aakashvishcoder/risc-v-comp/risc-v comp.kicad_pcb

## KiCad design risc-v comp.kicad_pcb (2026-11-08)

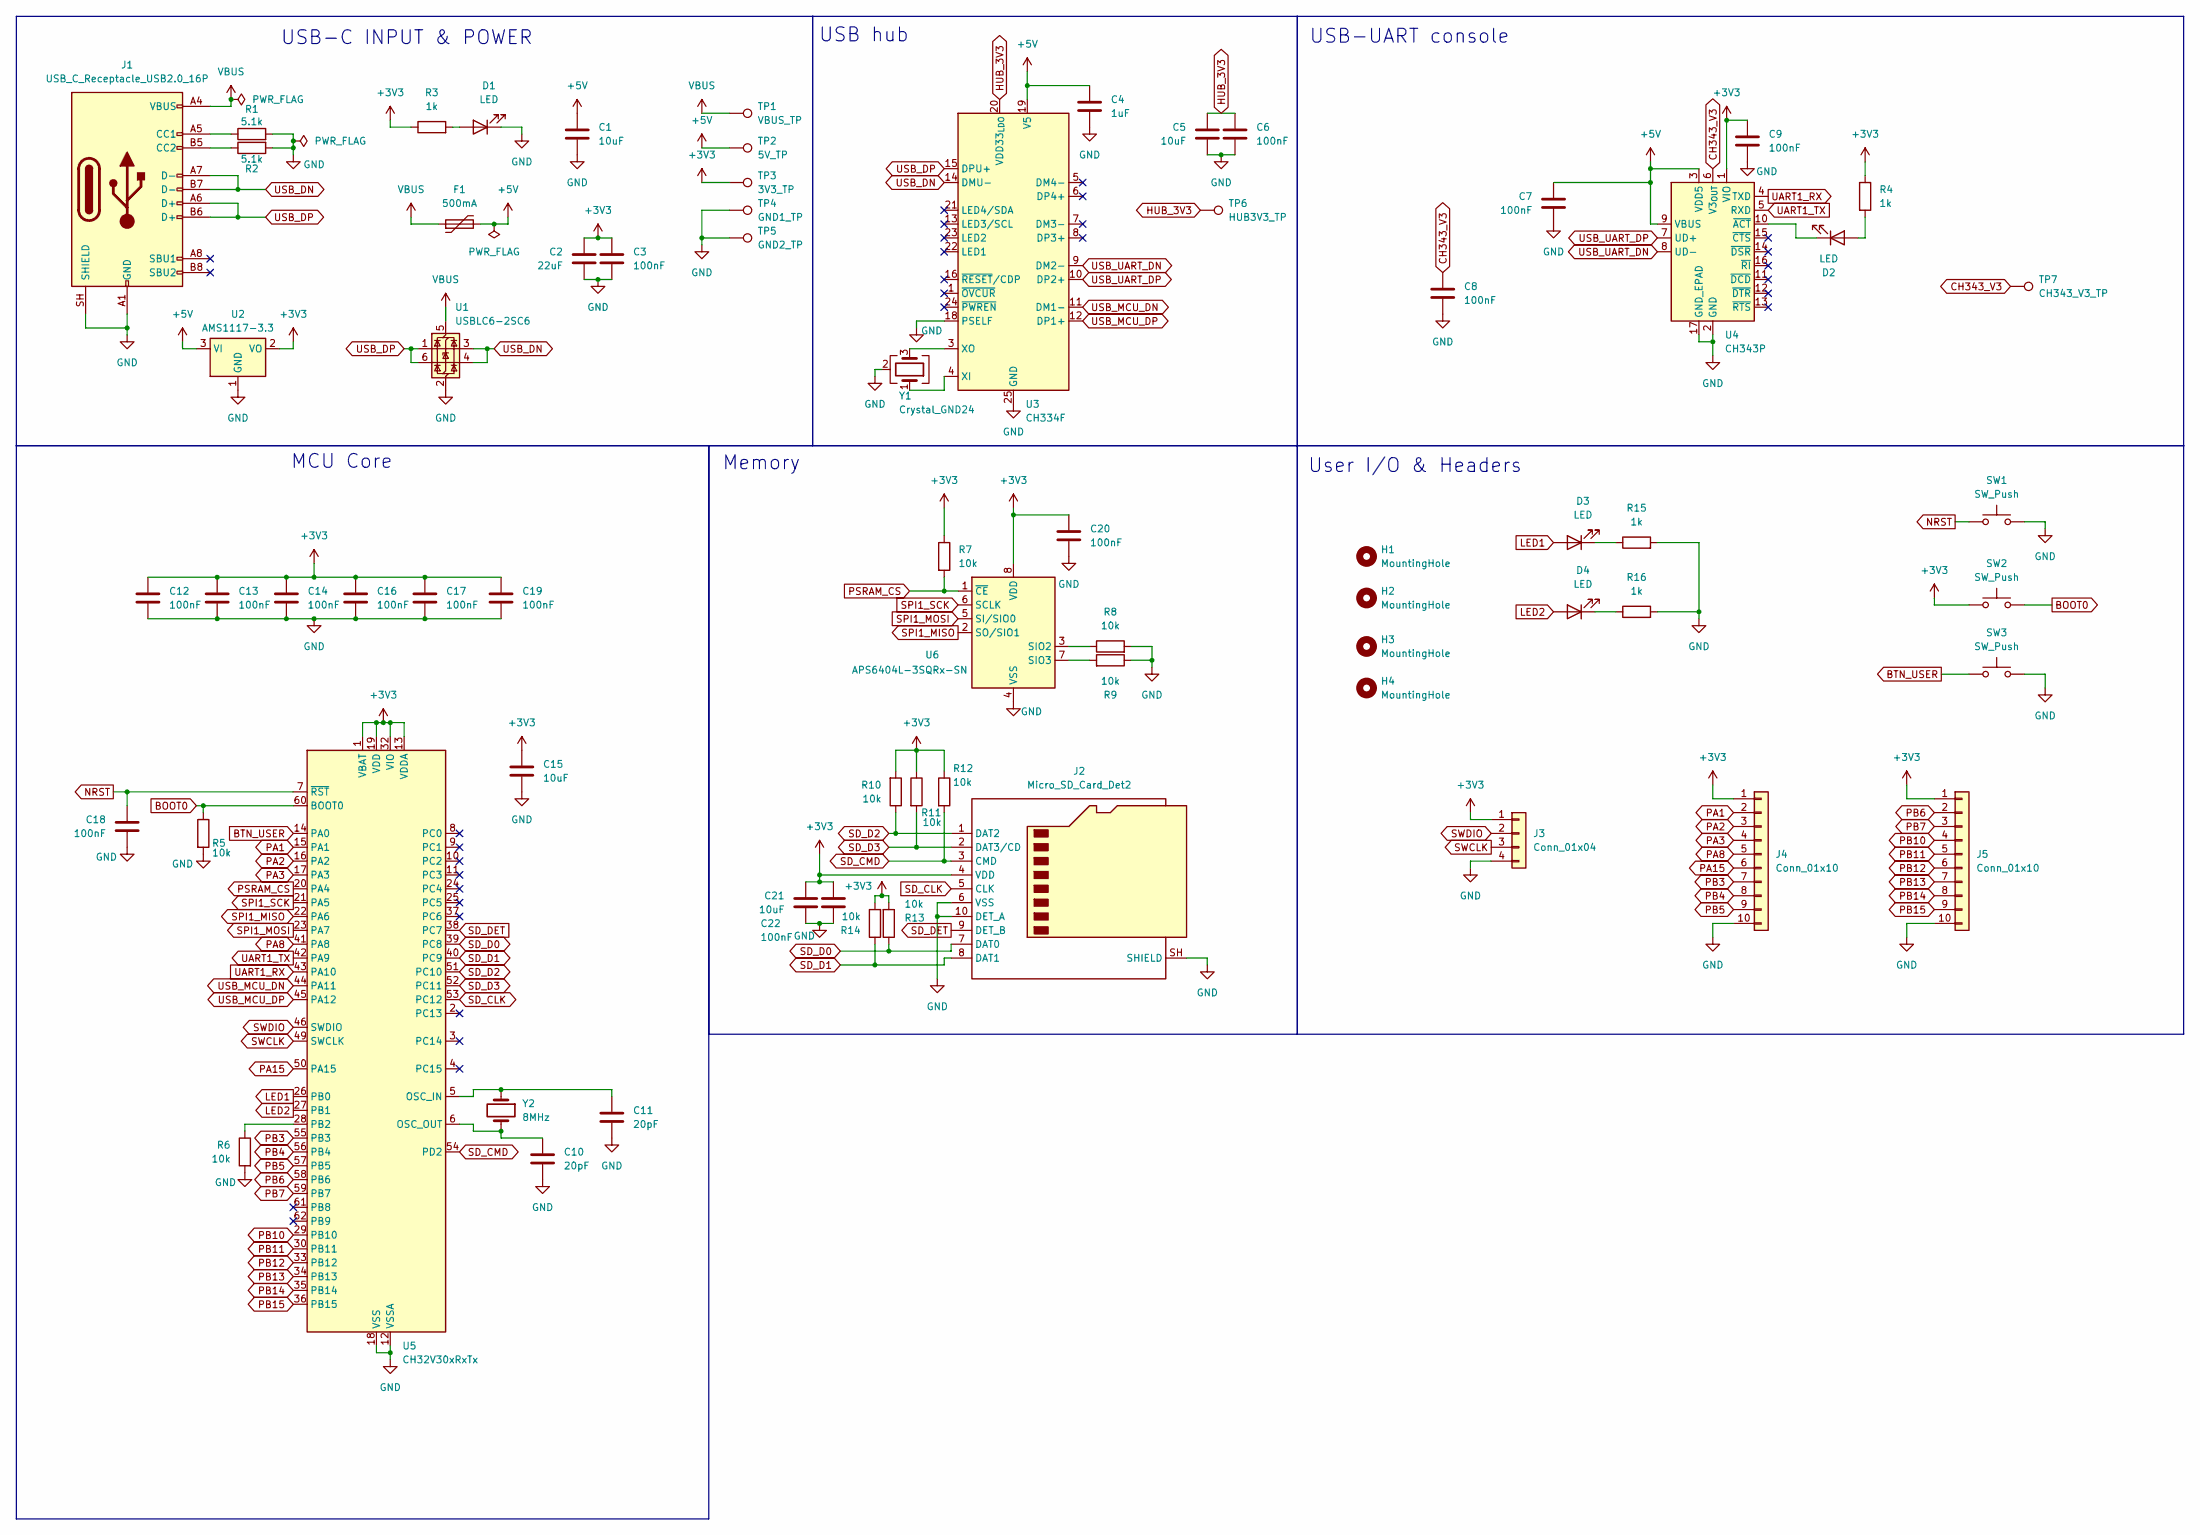
[picture p1: schematic risc-v comp.kicad_sch]

Parts:
C1, C5, C15, C21: 10uF; C_0603_1608Metric; LCSC C19702
C2: 22uF; C_0805_2012Metric; LCSC C45783
C3, C6, C7, C8, C9, C12, C13, C14, C16, C17, C18, C19, C20, C22: 100nF; C_0402_1005Metric; LCSC C1525
C4: 1uF; C_0402_1005Metric; LCSC C52923
C10, C11: 20pF; C_0402_1005Metric; LCSC C1554
D1, D2, D3, D4: LED; LED_0603_1608Metric; LCSC C2286
F1: 500mA; Fuse_0805_2012Metric; LCSC C20978
H1, H2, H3, H4: MountingHole; MountingHole_2.7mm_M2.5
J1: USB_C_Receptacle_USB2.0_16P; USB_C_Receptacle_HRO_TYPE-C-31-M-12; LCSC C165948
J2: Micro_SD_Card_Det2; microSD_HC_Molex_104031-0811; LCSC C585350
J3: Conn_01x04; PinHeader_1x04_P2.54mm_Vertical; LCSC C2337
J4, J5: Conn_01x10; PinHeader_1x10_P2.54mm_Vertical; LCSC C2337
R1, R2: 5.1k; R_0402_1005Metric; LCSC C25905
R3, R4, R15, R16: 1k; R_0402_1005Metric; LCSC C11702
R5, R6, R7, R8, R9, R10, R11, R12, R13, R14: 10k; R_0402_1005Metric; LCSC C25744
SW1, SW2, SW3: SW_Push; SW_Push_1P1T_XKB_TS-1187A; LCSC C318884
TP1: VBUS_TP; TestPoint_Pad_D1.5mm
TP2: 5V_TP; TestPoint_Pad_D1.5mm
TP3: 3V3_TP; TestPoint_Pad_D1.5mm
TP4: GND1_TP; TestPoint_Pad_D1.5mm
TP5: GND2_TP; TestPoint_Pad_D1.5mm
TP6: HUB3V3_TP; TestPoint_Pad_D1.5mm
TP7: CH343_V3_TP; TestPoint_Pad_D1.5mm
U1: USBLC6-2SC6; SOT-23-6; LCSC C7519
U2: AMS1117-3.3; SOT-223-3_TabPin2; LCSC C6186
U3: CH334F; QFN-24-1EP_4x4mm_P0.5mm_EP2.7x2.7mm; LCSC C5187527
U4: CH343P; WCH_QFN-16-1EP_3x3mm_P0.5mm_EP1.8x1.8mm; LCSC C2846043
U5: CH32V30xRxTx; LQFP-64_10x10mm_P0.5mm; LCSC C2988083
U6: APS6404L-3SQRx-SN; SOIC-8_3.9x4.9mm_P1.27mm; LCSC C5333729
Y1: Crystal_GND24; Crystal_SMD_3225-4Pin_3.2x2.5mm; LCSC C9002
Y2: 8MHz; Crystal_SMD_5032-2Pin_5.0x3.2mm; LCSC C115962

Connections:
+3V3: C2.1, C3.1, C9.1, C12.1, C13.1, C14.1, C15.1, C16.1, C17.1, C19.1, C20.1, C21.1, C22.1, J2.4 (VDD), J3.1, J4.1, J5.1, R3.1, R4.1, R7.1, R10.2, R11.1, R12.1, R13.2, R14.2, SW2.1, TP3.1 (1_1), U2.2 (VO), U4.1 (VIO), U5.1 (VBAT), U5.13 (VDDA), U5.19 (VDD), U5.32 (VIO), U5.48 (VDD), U5.64 (VIO), U6.8 (VDD)
+5V: C1.1, C4.1, C7.1, F1.2, TP2.1 (1_1), U2.3 (VI), U3.19 (V5), U4.3 (VDD5), U4.9 (VBUS)
BOOT0: R5.1, SW2.2, U5.60 (BOOT0)
BTN_USER: SW3.1, U5.14 (PA0)
CH343_V3: C8.1, TP7.1 (1_1), U4.6 (V3_{OUT})
GND: C1.2, C2.2, C3.2, C4.2, C5.2, C6.2, C7.2, C8.2, C9.2, C10.1, C11.2, C12.2, C13.2, C14.2, C15.2, C16.2, C17.2, C18.2, C19.2, C20.2, C21.2, C22.2, D1.1 (K), J1.A1 (GND), J1.A12 (GND), J1.B1 (GND), J1.B12 (GND), J1.SH (SHIELD), J2.6 (VSS), J2.10 (DET_A), J2.SH (SHIELD), J3.4, J4.10, J5.10, R1.2, R2.2, R5.2, R6.2, R8.2, R9.1, R15.2, R16.2, SW1.2, SW3.2, TP4.1 (1_1), TP5.1 (1_1), U1.2 (GND), U2.1 (GND), U3.18 (PSELF), U3.25 (GND), U4.2 (GND), U4.17 (GND_EPAD), U5.12 (VSSA), U5.18 (VSS), U5.31 (VSS), U5.47 (VSS), U5.63 (VSS), U6.4 (VSS), Y1.2 (G), Y1.4 (G)
HUB_3V3: C5.1, C6.1, TP6.1 (1_1), U3.20 (VDD33_{LDO})
LED1: D3.2 (A), U5.26 (PB0)
LED2: D4.2 (A), U5.27 (PB1)
NRST: C18.1, SW1.1, U5.7 (~RST)
unnamed: D1.2 (A), R3.2
unnamed: D2.2 (A), R4.2
unnamed: D2.1 (K), U4.10 (~ACT)
unnamed: D3.1 (K), R15.1
unnamed: D4.1 (K), R16.1
unnamed: J1.A5 (CC1), R1.1
unnamed: J1.B5 (CC2), R2.1
unnamed: U3.4 (XI), Y1.1
unnamed: U3.3 (XO), Y1.3
unnamed: C11.1, U5.5 (OSC_IN), Y2.1
unnamed: C10.2, U5.6 (OSC_OUT), Y2.2
unnamed: R6.1, U5.28 (PB2)
unnamed: R8.1, U6.3 (SIO2)
unnamed: R9.2, U6.7 (SIO3)
PA1: J4.2, U5.15 (PA1)
PA2: J4.3, U5.16 (PA2)
PA3: J4.4, U5.17 (PA3)
PA8: J4.5, U5.41 (PA8)
PA15: J4.6, U5.50 (PA15)
PB3: J4.7, U5.55 (PB3)
PB4: J4.8, U5.56 (PB4)
PB5: J4.9, U5.57 (PB5)
PB6: J5.2, U5.58 (PB6)
PB7: J5.3, U5.59 (PB7)
PB10: J5.4, U5.29 (PB10)
PB11: J5.5, U5.30 (PB11)
PB12: J5.6, U5.33 (PB12)
PB13: J5.7, U5.34 (PB13)
PB14: J5.8, U5.35 (PB14)
PB15: J5.9, U5.36 (PB15)
PSRAM_CS: R7.2, U5.20 (PA4), U6.1 (~CE)
SD_CLK: J2.5 (CLK), U5.53 (PC12)
SD_CMD: J2.3 (CMD), R12.2, U5.54 (PD2)
SD_D0: J2.7 (DAT0), R13.1, U5.39 (PC8)
SD_D1: J2.8 (DAT1), R14.1, U5.40 (PC9)
SD_D2: J2.1 (DAT2), R10.1, U5.51 (PC10)
SD_D3: J2.2 (DAT3/CD), R11.2, U5.52 (PC11)
SD_DET: J2.9 (DET_B), U5.38 (PC7)
SPI1_MISO: U5.22 (PA6), U6.2 (SO/SIO1)
SPI1_MOSI: U5.23 (PA7), U6.5 (SI/SIO0)
SPI1_SCK: U5.21 (PA5), U6.6 (SCLK)
SWCLK: J3.3, U5.49 (SWCLK)
SWDIO: J3.2, U5.46 (SWDIO)
UART1_RX: U4.4 (TXD), U5.43 (PA10)
UART1_TX: U4.5 (RXD), U5.42 (PA9)
USB_DN: J1.A7 (D-), J1.B7 (D-), U1.3 (I/O2), U1.4 (I/O2), U3.14 (DMU-)
USB_DP: J1.A6 (D+), J1.B6 (D+), U1.1 (I/O1), U1.6 (I/O1), U3.15 (DPU+)
USB_MCU_DN: U3.11 (DM1-), U5.44 (PA11)
USB_MCU_DP: U3.12 (DP1+), U5.45 (PA12)
USB_UART_DN: U3.9 (DM2-), U4.8 (UD-)
USB_UART_DP: U3.10 (DP2+), U4.7 (UD+)
VBUS: F1.1, J1.A4 (VBUS), J1.A9 (VBUS), J1.B4 (VBUS), J1.B9 (VBUS), TP1.1 (1_1), U1.5 (VBUS)

Notes on the sheet:
USB-UART console
USB hub
User I/O & Headers
Memory
MCU Core
USB-C INPUT & POWER

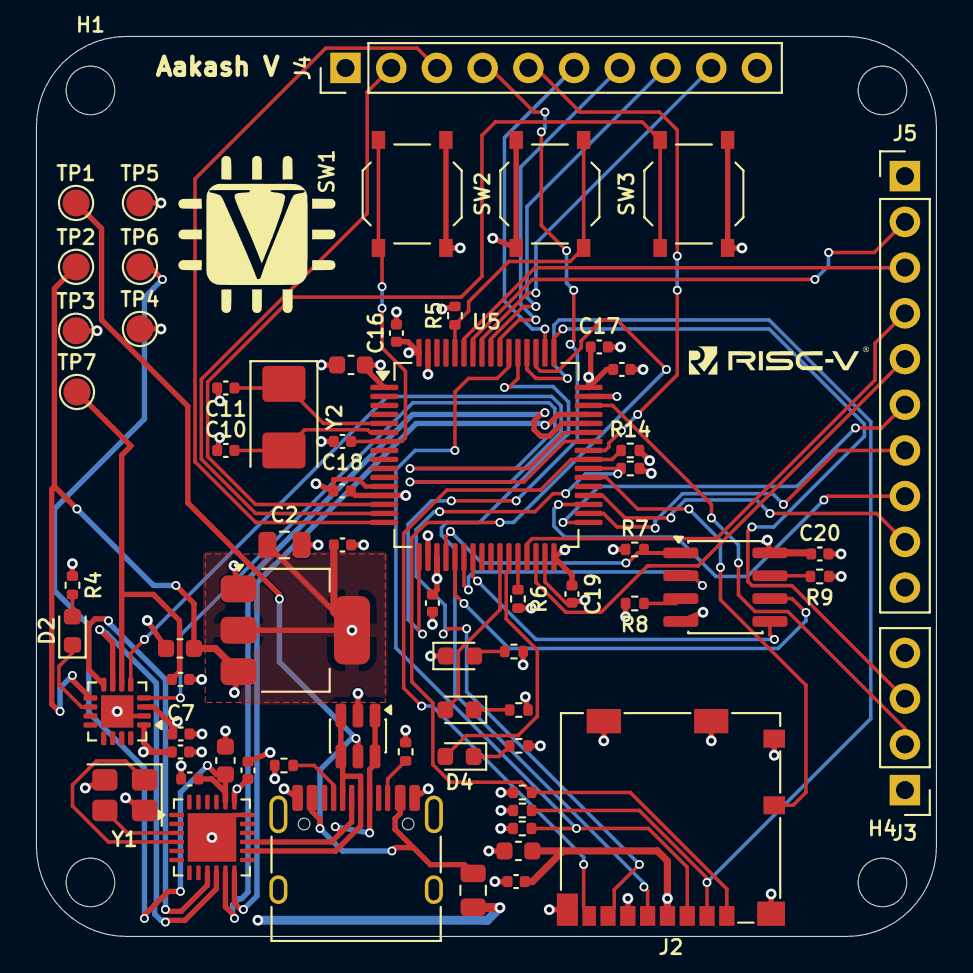
[picture p2: board risc-v comp.kicad_pcb from above]

Board: 4 copper layers, 50.0 x 50.0 mm, 70 parts (0 on the bottom side), 62 nets.
