aakashvishcoder/risc-v-comp/(commit log)

2026-11-06 Initial commit: KiCad project, BOM, section 1 schematic guide
    [BOM.csv, risc-v comp.kicad_pcb, risc-v comp.kicad_sch]
2026-11-06 Section 1: USB-C input and power schematic (ERC clean)
    [risc-v comp.kicad_sch]
2026-11-06 Section 2: USB hub (CH334F) schematic
    [BOM.csv, risc-v comp.kicad_sch]
2026-11-06 Section 3: USB-UART console (CH343P) schematic
    [BOM.csv, risc-v comp.kicad_sch]
2026-11-06 Schematic: section 4 MCU core (CH32V307RCT6)
    [BOM.csv, risc-v comp.kicad_sch]
2026-11-06 Schematic: section 5 memory (PSRAM + microSD)
    [BOM.csv, risc-v comp.kicad_sch]
2026-11-06 Schematic: section 6 user I/O, schematic complete (ERC clean)
    [risc-v comp.kicad_sch]
2026-11-06 Add PCB setup and placement guide
2026-11-07 PCB: board setup, design rules, zones, and component placement
    [risc-v comp.kicad_pcb, risc-v comp.kicad_sch]
2026-11-08 PCB: complete routing, power vias, and rule fixes
    - Route all remaining nets; DRC clean (0 errors, 0 unconnected)
    - Tie J1 D+/D- pad pairs; upstream USB pair fully connected
    - Fan out GND/+3V3/+5V pads to inner planes
    - Shrink In2 +5V region so U2's output reaches the +3V3 plane; feed it from F1
    - Split USB FS rule per pair, relax FS/SD limits, drop HS skew check
    - Shrink/hide colliding reference designators
    - Power net class 0.3/0.15 in the placement guide
    [risc-v comp.kicad_pcb, risc-v comp.kicad_sch]
